Abhijithuprabhu/NightWatch/hardware/images/README.md

# Hardware Images
 filenames:
- `system_overview.png` — full system block diagram
- `uwb_anchor_wiring.jpeg` — Vacus ESP32-DW1000 anchor wiring
- `wearable_tag_wiring.jpeg` — tag with IMU + magnetometer
- `mmwave_node_wiring.jpeg` — DFRobot C1001 + ESP32 wiring
- `dashboard_screenshot.png` — NightWatch dashboard UI
