Abhijithuprabhu/NightWatch/(commit log)

2026-06-07 Initial commit — NightWatch v1 complete
2026-06-07 Add hardware circuit diagrams
2026-06-07 Enhance README with hardware photos and BOM update
    Added hardware photos and updated BOM estimation.
